DanielCoronadoM/State_Machine-VHDL/imagenes/IMG20221103141543.jpg

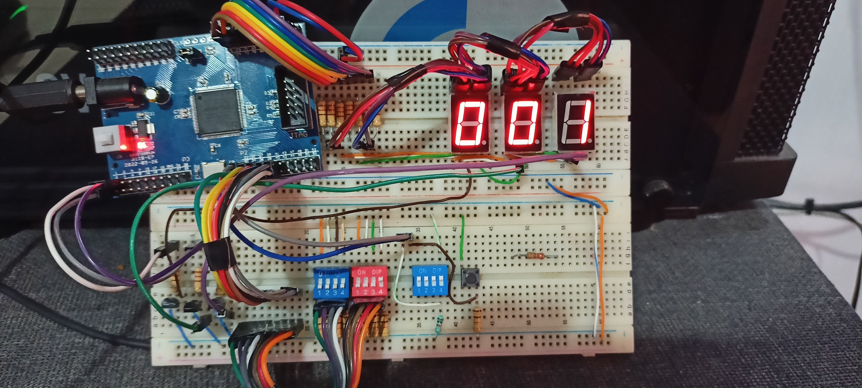
imagenes/IMG20221103141543.jpg
