DanielCoronadoM/State_Machine-VHDL/imagenes/IMG20221103141457.jpg

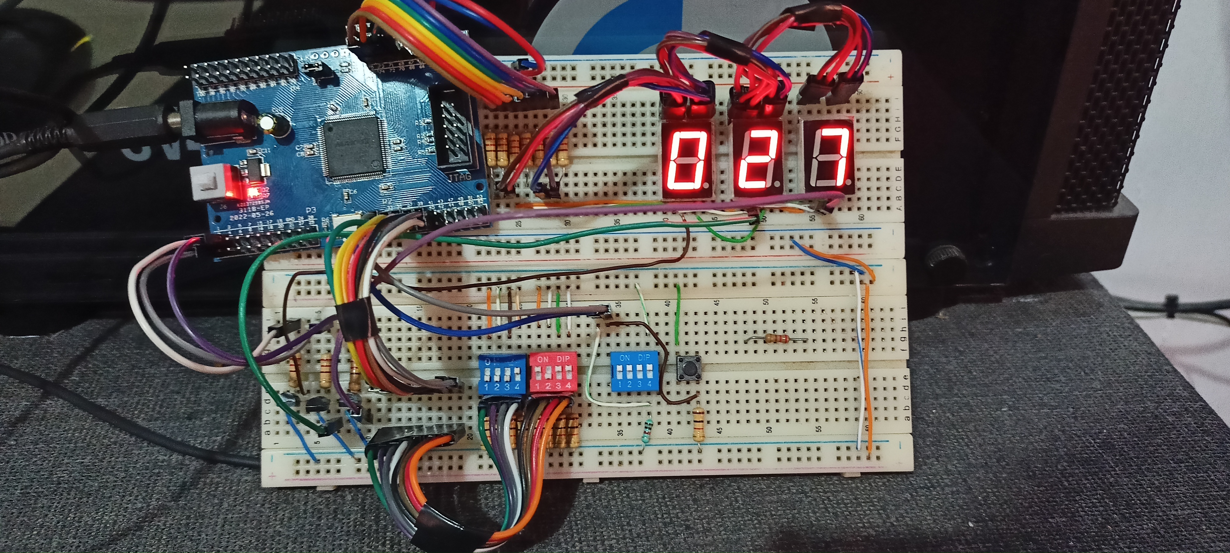
imagenes/IMG20221103141457.jpg
