DanielCoronadoM/State_Machine-VHDL/imagenes/algoritmo.png

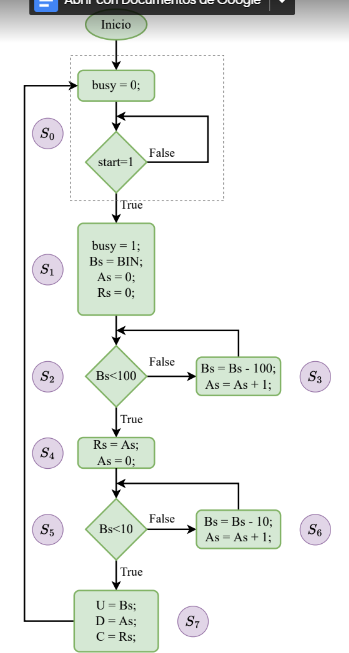
imagenes/algoritmo.png
