DanielCoronadoM/State_Machine-VHDL/imagenes/asignacion de pines.png

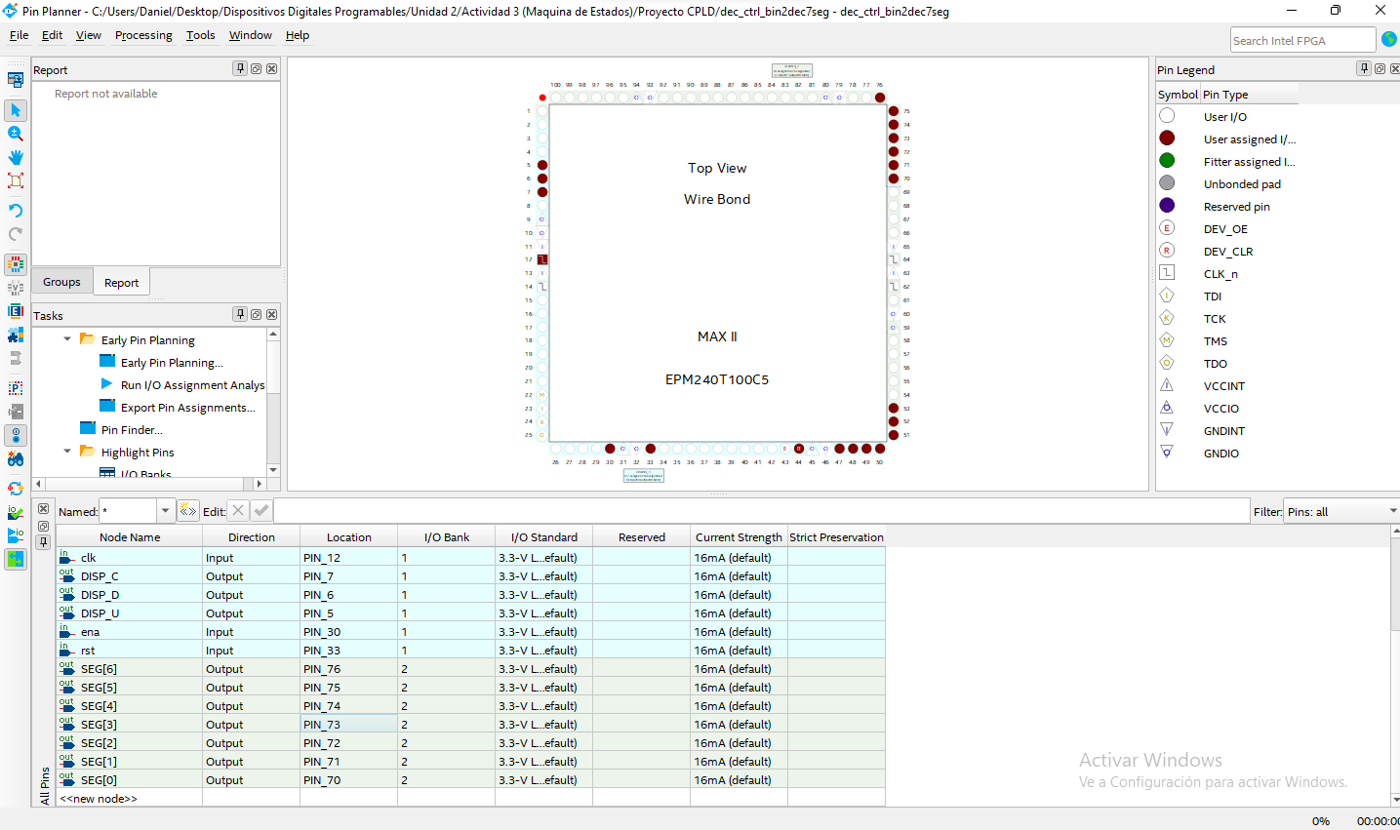
imagenes/asignacion de pines.png
