DanielCoronadoM/State_Machine-VHDL/imagenes/asm_example.png

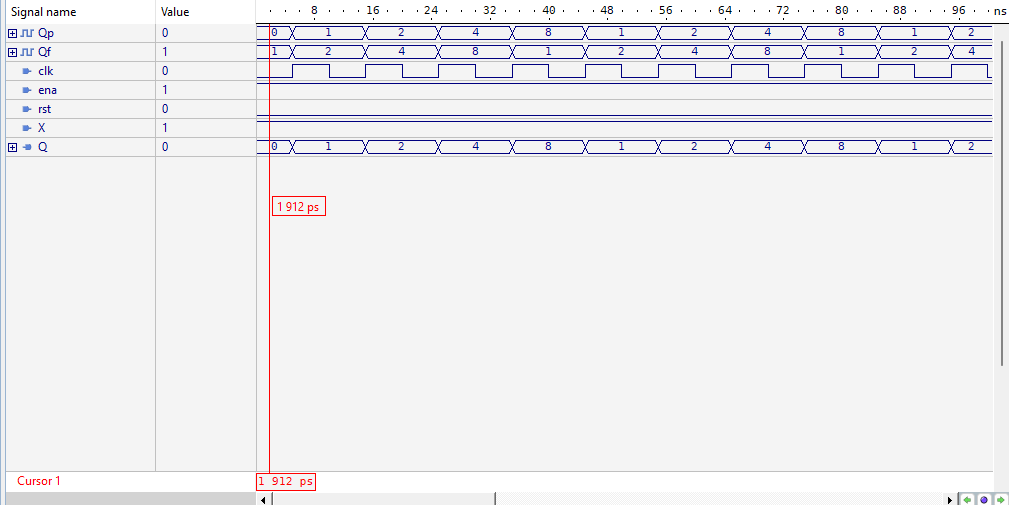
imagenes/asm_example.png
