DanielCoronadoM/State_Machine-VHDL/imagenes/CATODO COMUN.png

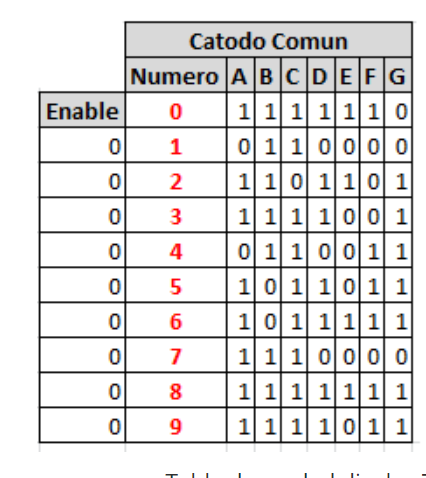
imagenes/CATODO COMUN.png
