DanielCoronadoM/State_Machine-VHDL/imagenes/conv_b2d.png

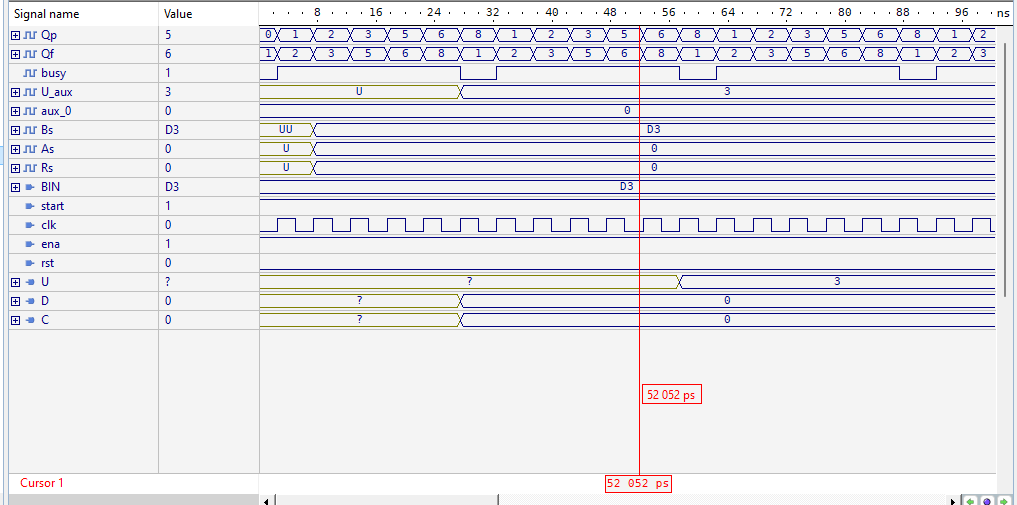
imagenes/conv_b2d.png
