DanielCoronadoM/State_Machine-VHDL/imagenes/IMG20221028210145.jpg

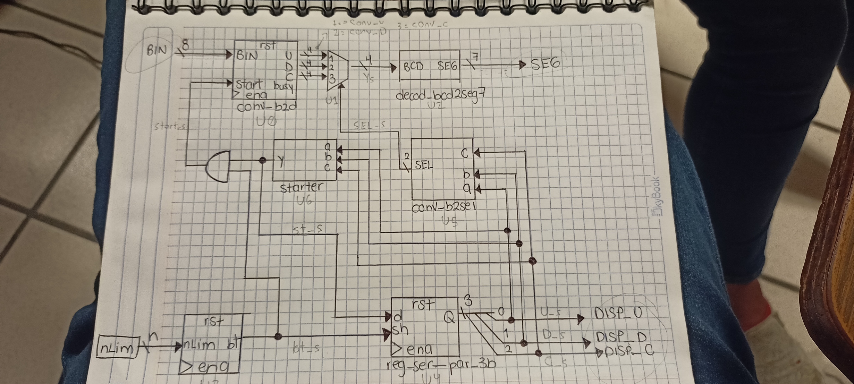
imagenes/IMG20221028210145.jpg
