DanielCoronadoM/State_Machine-VHDL/imagenes/Orden displays.png

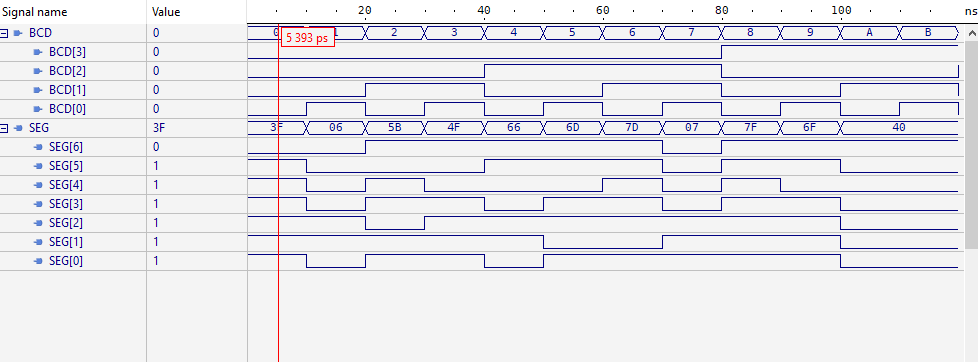
imagenes/Orden displays.png
