DanielCoronadoM/State_Machine-VHDL/imagenes/RTL.png

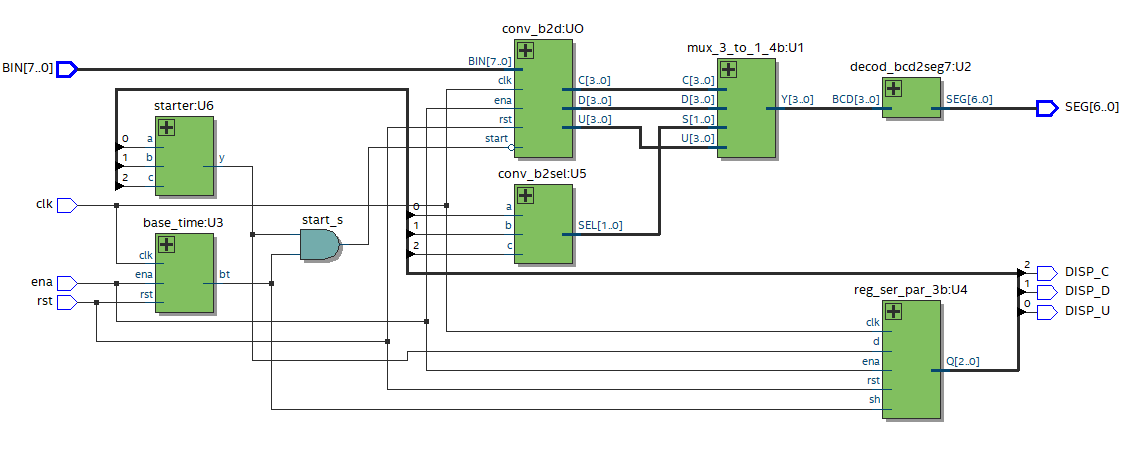
imagenes/RTL.png
