DanielCoronadoM/State_Machine-VHDL/imagenes/Simulacion.png

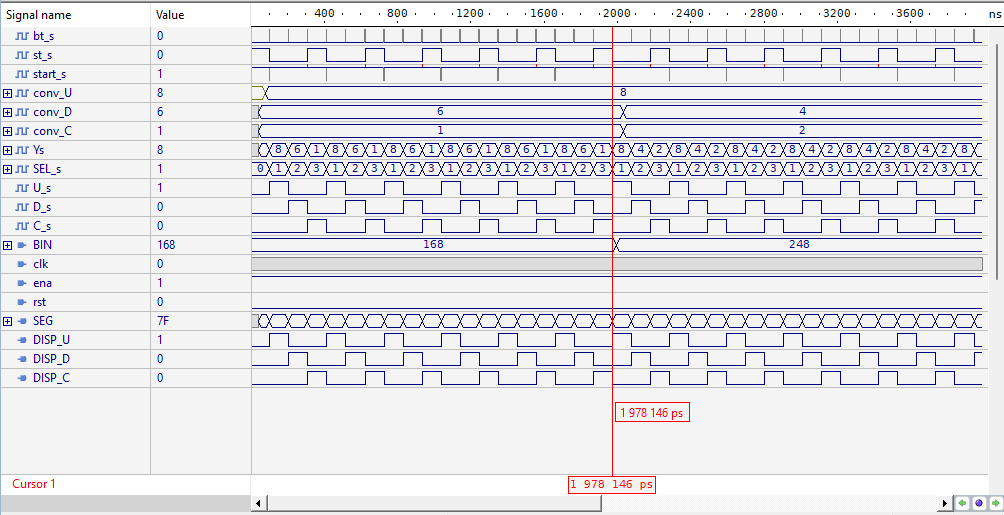
imagenes/Simulacion.png
