DanielCoronadoM/State_Machine-VHDL/(list of files, drawings)

Other design files:
Esquematico/State Machine.pdsprj
