DanielCoronadoM/State_Machine-VHDL/Maquina_de_Estados/UTP/State_Machine/compile.cfg

[View]
Entity=conv_b2d
Architecture=artithmetic
TopLevelType=1
[file:.\src\dec_ctrl_bin2dec7seg.vhd]
Enabled=1
[file:.\src\U0_conv_b2d.vhd]
Enabled=1
[file:.\src\U1_mux_3_to_1_4b.vhd]
Enabled=1
[file:.\src\U2_decod_bcd2seg7.vhd]
Enabled=1
[file:.\src\U3_base_time.vhd]
Enabled=1
[file:.\src\U4_reg_ser_par_3b.vhd]
Enabled=1
[file:.\src\U5_conv_b2sel.vhd]
Enabled=1
[file:.\src\U6_starter.vhd]
Enabled=1
[file:.\src\U3_reg_nbits.vhd]
Enabled=1
[file:.\src\U3_comp_n_bits.vhd]
Enabled=1
[file:.\src\U3_adder_nbits.vhd]
Enabled=1
