DanielCoronadoM/State_Machine-VHDL/(commit log)

2022-11-04 Primer commit
    [State Machine.pdsprj, compile.cfg, library.cfg, projlib.cfg]
2022-11-04 Se agrego carpeta de imagenes
2022-11-04 new vhd names
    [compile.cfg]
2022-11-04 Maquina de estados deleted
2022-11-04 Doc and rename vhd names
    [compile.cfg]
